Phong2114404/VXL-XeDK/PCB_3D_TOP.png

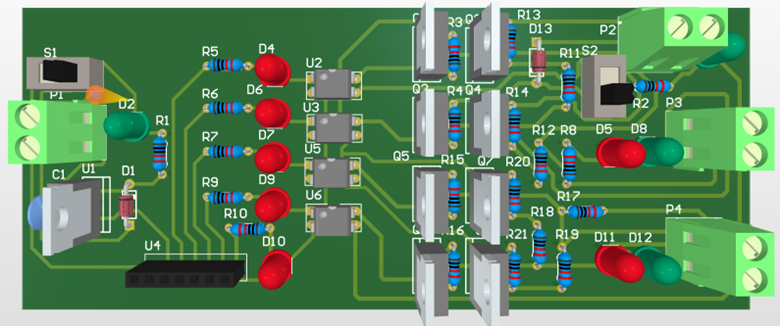
PCB_3D_TOP.png
