Phong2114404/VXL-XeDK/PCB_2D.png

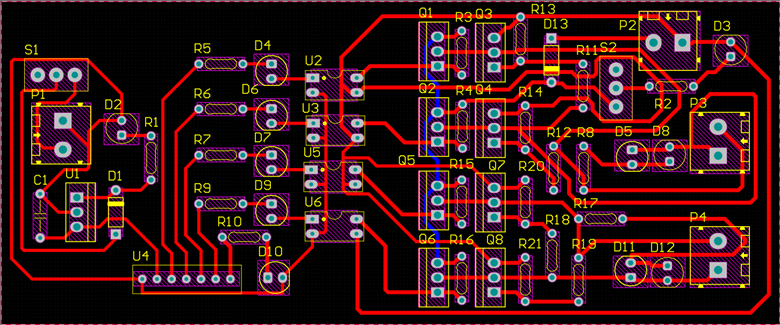
PCB_2D.png
