Phong2114404/VXL-XeDK/(list of files, drawings)

Other design files:
Project/Xedieukhien.PrjPcb
Project/xedieukhien.SCHLIB
Project/Xedk.PcbDoc
Project/Xedk.PcbLib
Project/Xedk.SchDoc
